Nanohumano/chapa-nh/caja/gruesa_800mAh/corredera.png

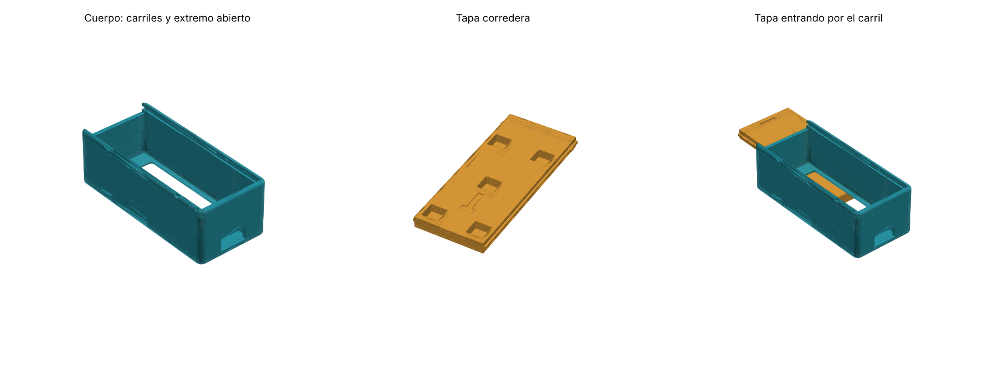
caja/gruesa_800mAh/corredera.png
