Nanohumano/chapa-nh/caja/gruesa_800mAh/detalle.png

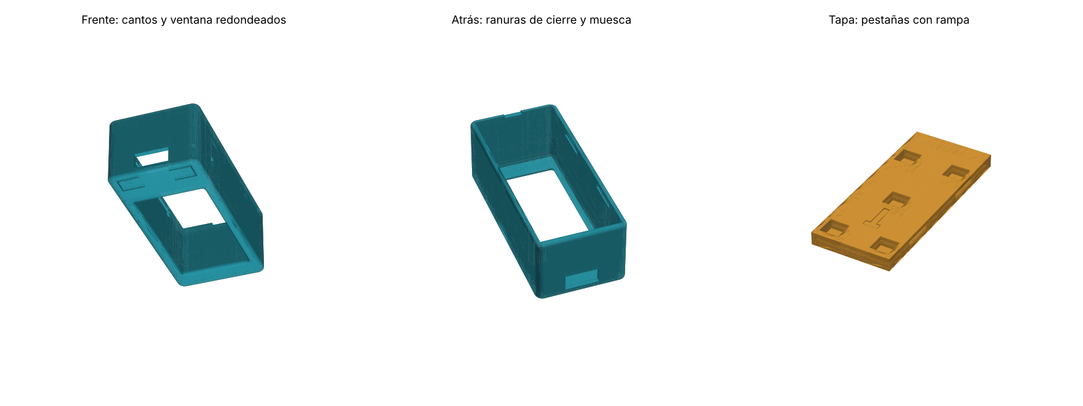
caja/gruesa_800mAh/detalle.png
