Nanohumano/chapa-nh/caja/gruesa_800mAh/chapa_nh_cuerpo.stl

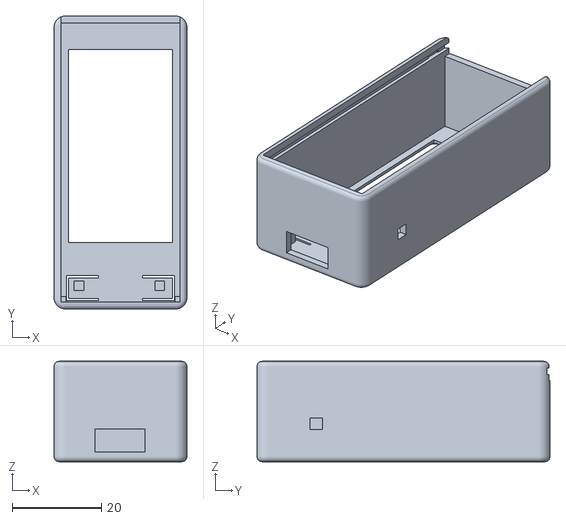
[picture p7: CAD file, 2026-11-11]
caja/gruesa_800mAh/chapa_nh_cuerpo.stl
29.8 x 65.6 x 22.6
