Nanohumano/chapa-nh/caja/plana_1200mAh/chapa_nh_pie.stl

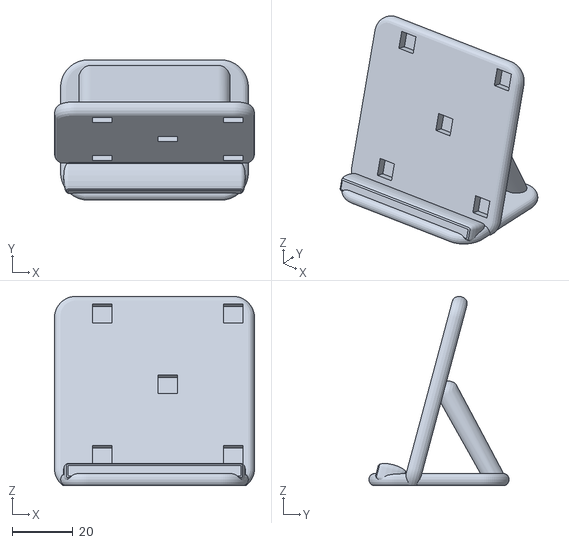
[picture p8: CAD file, 2026-11-11]
caja/plana_1200mAh/chapa_nh_pie.stl
65.6 x 46.0 x 62.1
