Nanohumano/chapa-nh/caja/plana_1200mAh/otros_pies/chapa_nh_pie_lowpoly.stl

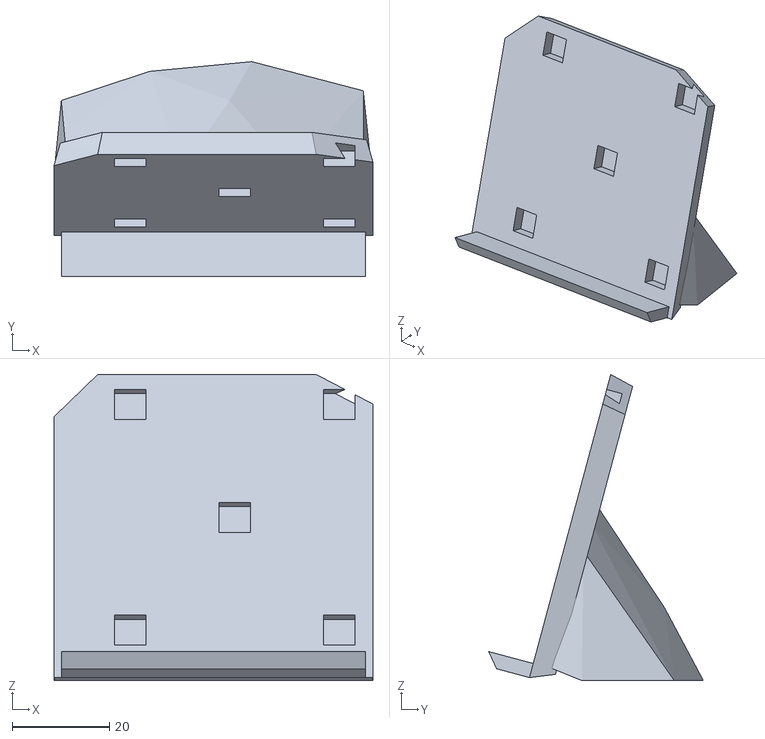
[picture p9: CAD file, 2026-11-11]
caja/plana_1200mAh/otros_pies/chapa_nh_pie_lowpoly.stl
65.6 x 44.2 x 63.0
