Nanohumano/chapa-nh/caja/gruesa_800mAh/chapa_nh_tapa.stl

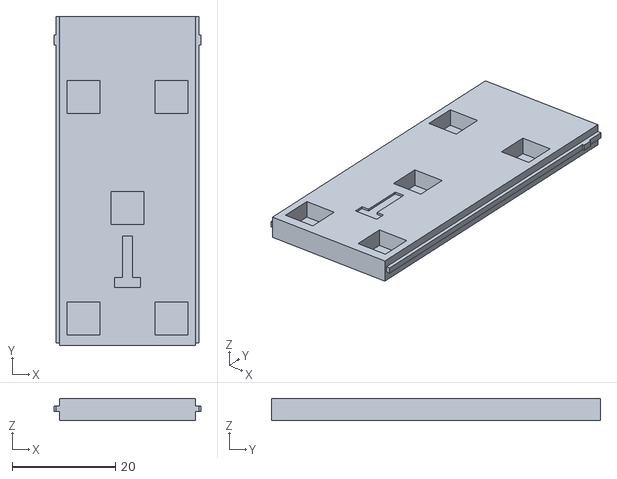
[picture p10: CAD file, 2026-11-11]
caja/gruesa_800mAh/chapa_nh_tapa.stl
28.5 x 63.9 x 4.30
