Nanohumano/chapa-nh/caja/plana_1200mAh/chapa_nh_tapa.stl

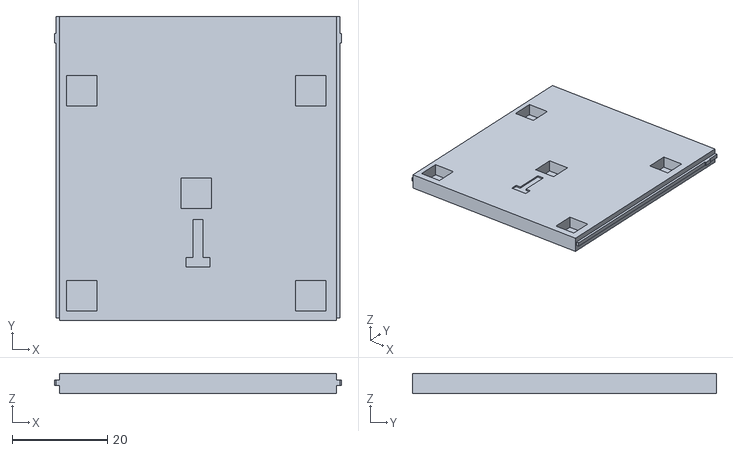
[picture p11: CAD file, 2026-11-11]
caja/plana_1200mAh/chapa_nh_tapa.stl
60.3 x 63.9 x 4.30
