Nanohumano/chapa-nh/caja/plana_1200mAh/otros_pies/chapa_nh_pie_basico.stl

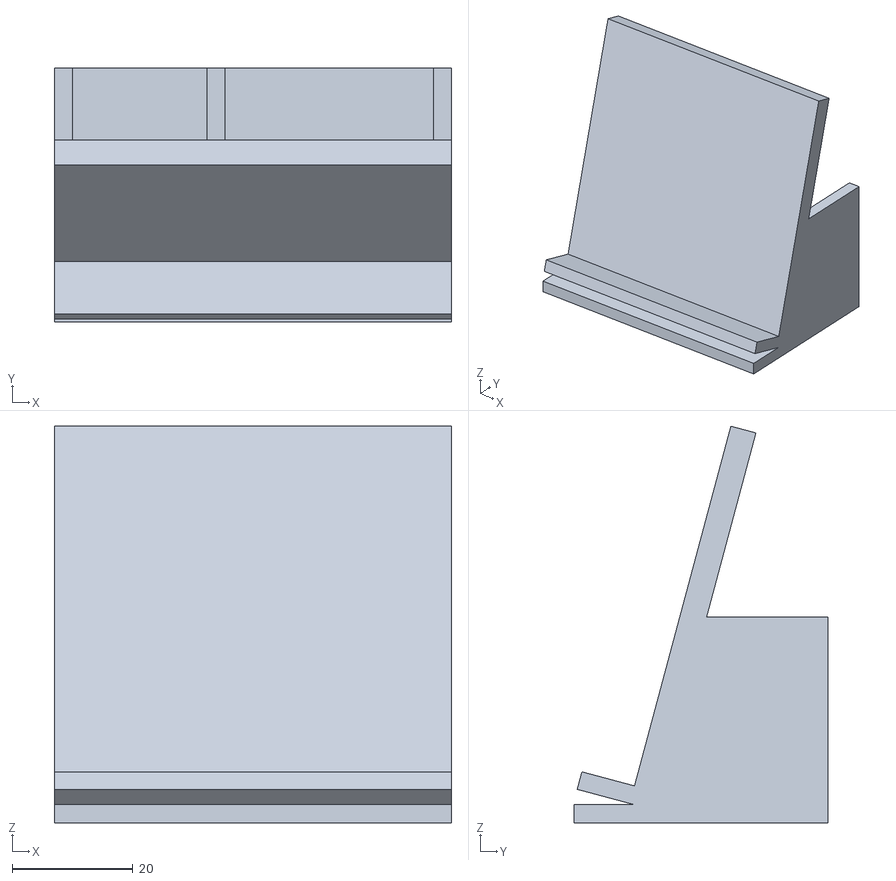
[picture p12: CAD file, 2026-11-11]
caja/plana_1200mAh/otros_pies/chapa_nh_pie_basico.stl
65.6 x 42.0 x 65.6
