Nanohumano/chapa-nh/caja/gruesa_800mAh/chapa_nh_contraplaca.stl

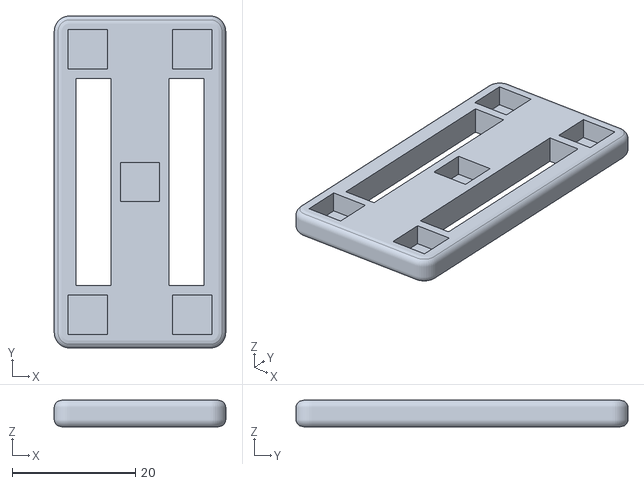
[picture p13: CAD file, 2026-11-11]
caja/gruesa_800mAh/chapa_nh_contraplaca.stl
27.8 x 53.8 x 4.30
