Nanohumano/chapa-nh/caja/plana_1200mAh/chapa_nh_cuerpo.stl

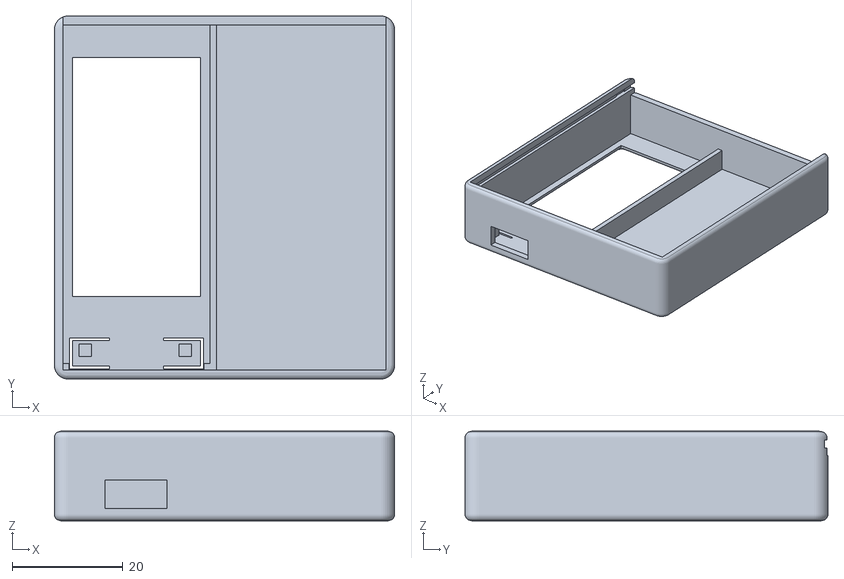
[picture p14: CAD file, 2026-11-11]
caja/plana_1200mAh/chapa_nh_cuerpo.stl
61.6 x 65.6 x 16.2
