Nanohumano/chapa-nh/caja/plana_1200mAh/chapa_nh_contraplaca.stl

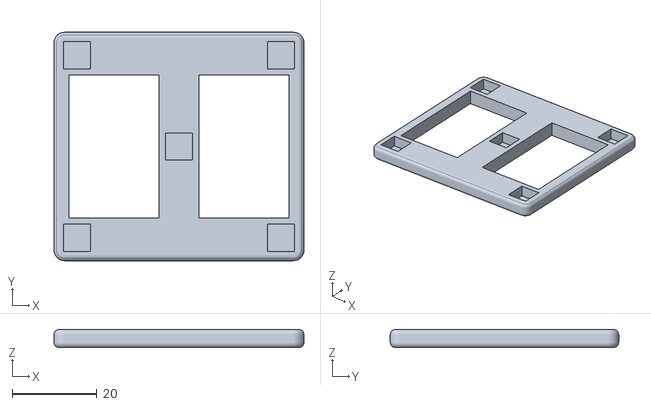
[picture p15: CAD file, 2026-11-11]
caja/plana_1200mAh/chapa_nh_contraplaca.stl
58.9 x 53.8 x 4.30
