Nanohumano/chapa-nh/(commit log)

2026-11-10 Chapa NH: app de control y firmware
    Claude-Session: https://claude.ai/code/session_01TtNH8SMP7DJwPqra8Ujtwe
2026-11-10 Caja v1: cuerpo, tapa con imanes y contraplaca
    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
    [chapa_nh_contraplaca.stl, chapa_nh_cuerpo.stl, chapa_nh_tapa.stl]
2026-11-10 Caja v2: 5 imanes (2 en cada extremo y 1 en el centro)
    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
    [chapa_nh_contraplaca.stl, chapa_nh_cuerpo.stl, chapa_nh_tapa.stl]
2026-11-10 Caja v3: esquinas redondeadas
    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
    [chapa_nh_contraplaca.stl, chapa_nh_cuerpo.stl]
2026-11-11 Caja v4: quitados los apoyos del extremo de la antena y de las esquinas del USB
    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
    [chapa_nh_cuerpo.stl]
2026-11-11 Caja v5: cantos y ventana redondeados, cierre de la tapa a presión
    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
    [chapa_nh_contraplaca.stl, chapa_nh_cuerpo.stl, chapa_nh_tapa.stl]
2026-11-11 Firmware y app v2: perfiles, temas animados, Adviento y avisos de batería
    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
2026-11-11 Caja v6: tapa corredera con carriles y clic
    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
    [chapa_nh_cuerpo.stl, chapa_nh_tapa.stl]
2026-11-11 Corrige los espacios que desaparecían en los textos
    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
    [chapa_nh.ino]
2026-11-11 App: nombre y empresa se envían solos al escribir y se comprueba que la chapa los guarda
    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
2026-11-11 README de NH-04, licencia MIT e imágenes
    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
2026-11-11 Nombres de ejemplo: Manolete y Eustakio; nueva portada
    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
2026-11-11 Enlace al vídeo de YouTube
    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
2026-11-11 README: enlace a Printables y cómo participar
    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
2026-11-11 Caja v7: batería 103040 en plano bajo la pantalla (16,2 mm), pie de mostrador con imanes
    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
    [chapa_nh_contraplaca.stl, chapa_nh_cuerpo.stl, chapa_nh_pie.stl, chapa_nh_tapa.stl]
2026-11-11 Caja: dos versiones a elegir (plana 1200 mAh con pie y gruesa 800 mAh)
    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
    [chapa_nh_contraplaca.stl, chapa_nh_cuerpo.stl, chapa_nh_pie.stl, chapa_nh_tapa.stl]
2026-11-11 Pie de mostrador moderno (redondeado, imanes enrasados) y pies alternativos low poly y básico
    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
    [chapa_nh_pie.stl, chapa_nh_pie_basico.stl, chapa_nh_pie_lowpoly.stl]
2026-11-11 Imágenes de la caja plana con el pie nuevo
    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
